dadi-vardhan/Assistive-Exoskelton/Fabricated_Design/Images/IMG-20190410-WA0003.jpg

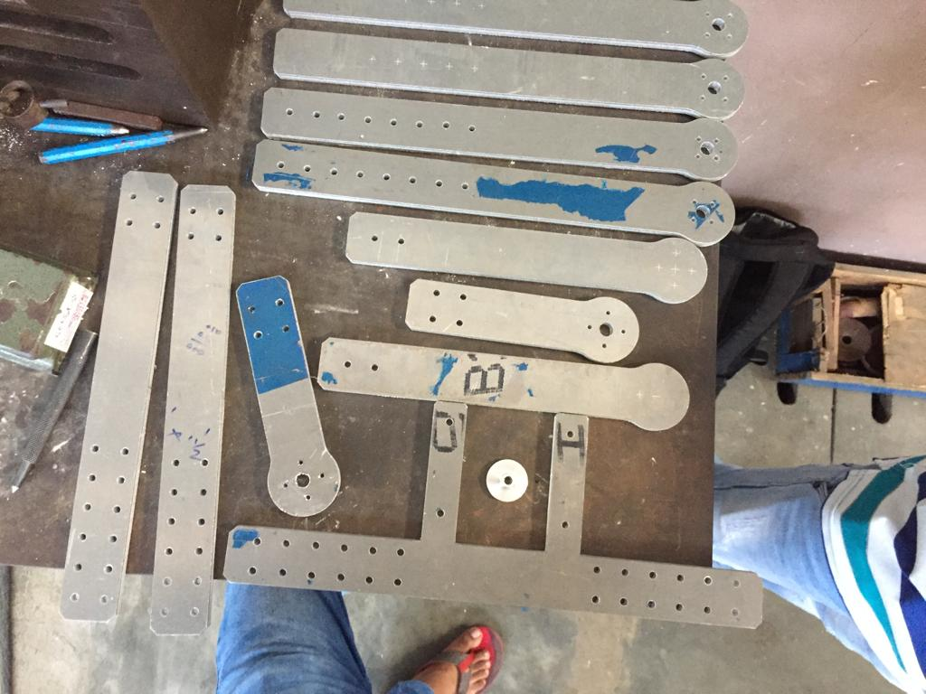
Fabricated_Design/Images/IMG-20190410-WA0003.jpg
