dadi-vardhan/Assistive-Exoskelton/Fabricated_Design/Images/Motor.PNG

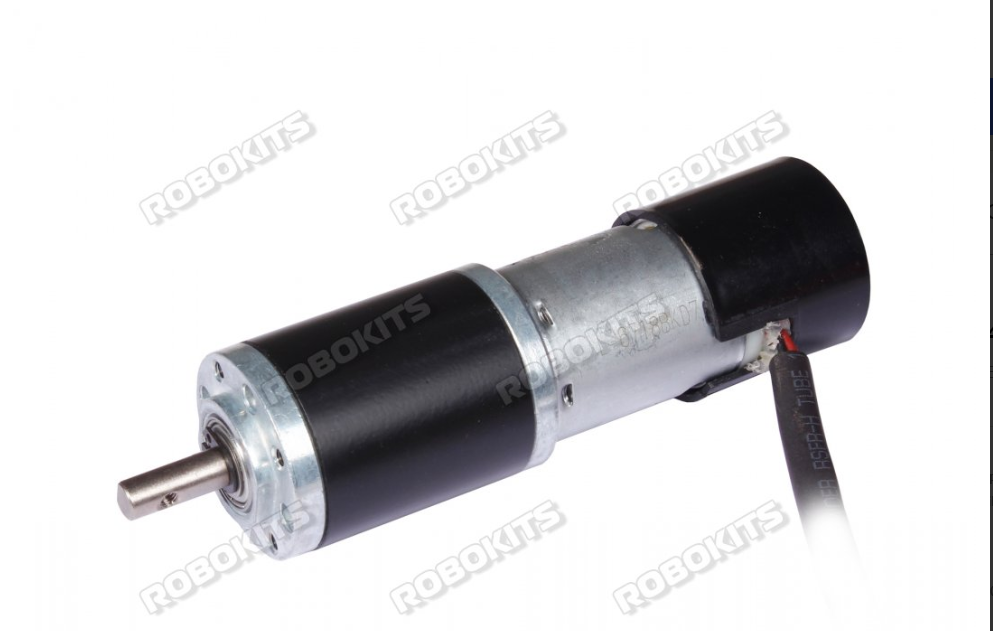
Fabricated_Design/Images/Motor.PNG
