dadi-vardhan/Assistive-Exoskelton/README.md

# Lower Limb Assistive Exoskeleton

Material = Aluminium 7075 T6;

DOF = SIX;

Type = Wearable Lower limb;

Drive_Type = Motor driven (DC brushless motors coupled with Harmonic Gear drive);

More details ------>>> [In the Report file]
