dadi-vardhan/Assistive-Exoskelton/Designed_Model/Images/Exoske1.JPG

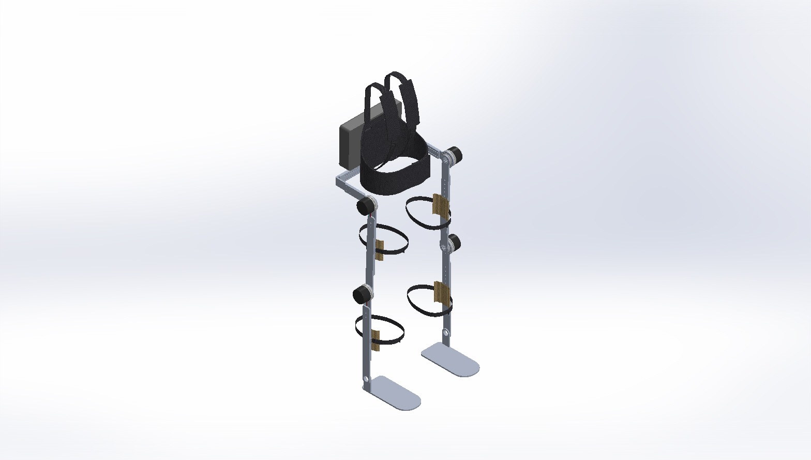
Designed_Model/Images/Exoske1.JPG
