dadi-vardhan/Assistive-Exoskelton/Designed_Model/Images/Exoskeleton.JPG

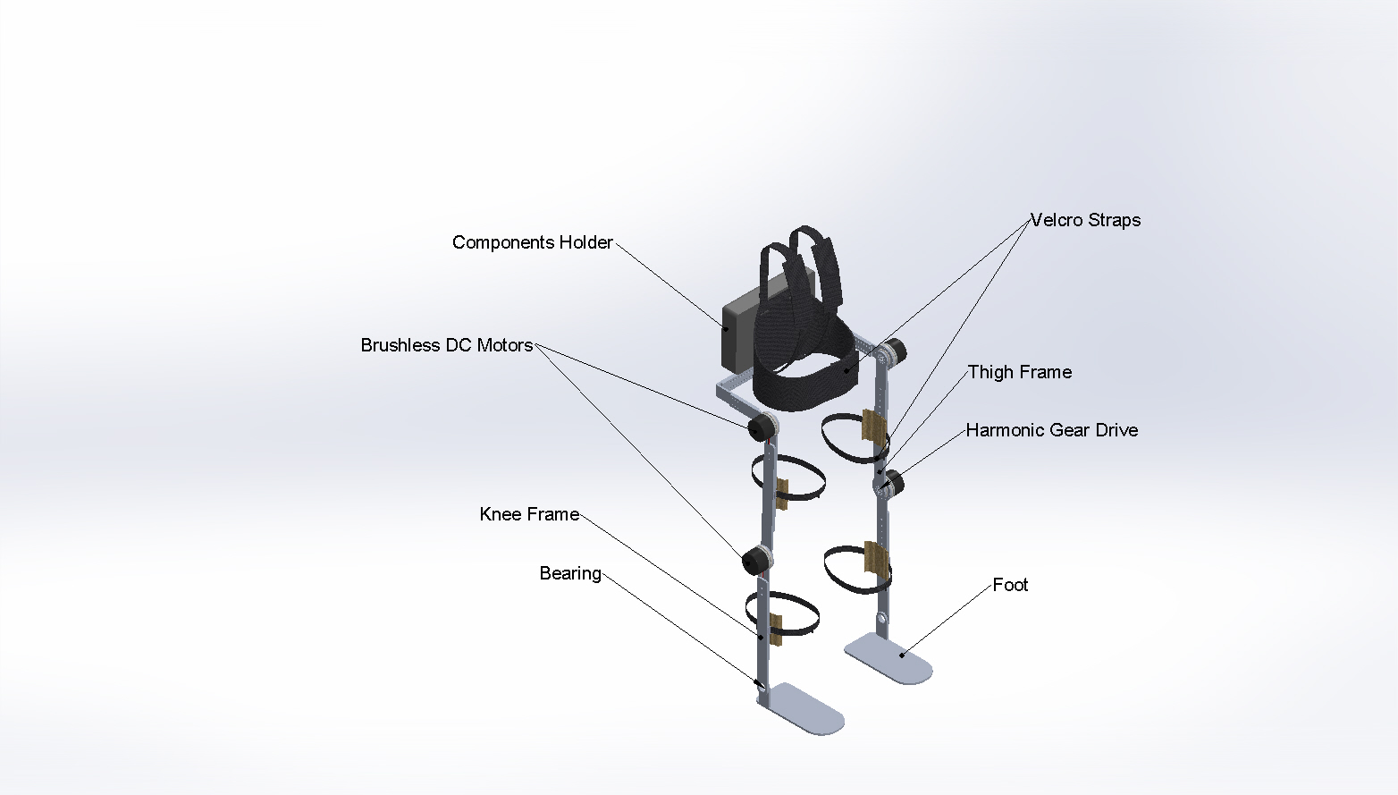
Designed_Model/Images/Exoskeleton.JPG
