dadi-vardhan/Assistive-Exoskelton/Designed_Model/Images/Height.JPG

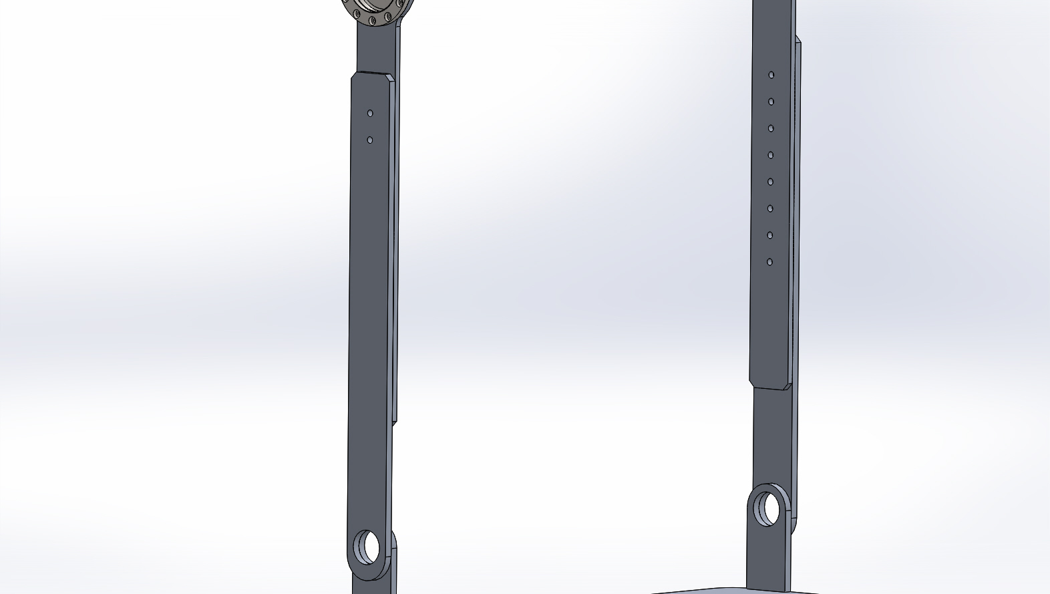
Designed_Model/Images/Height.JPG
