dadi-vardhan/Assistive-Exoskelton/Designed_Model/Images/HipAnalysis.JPG

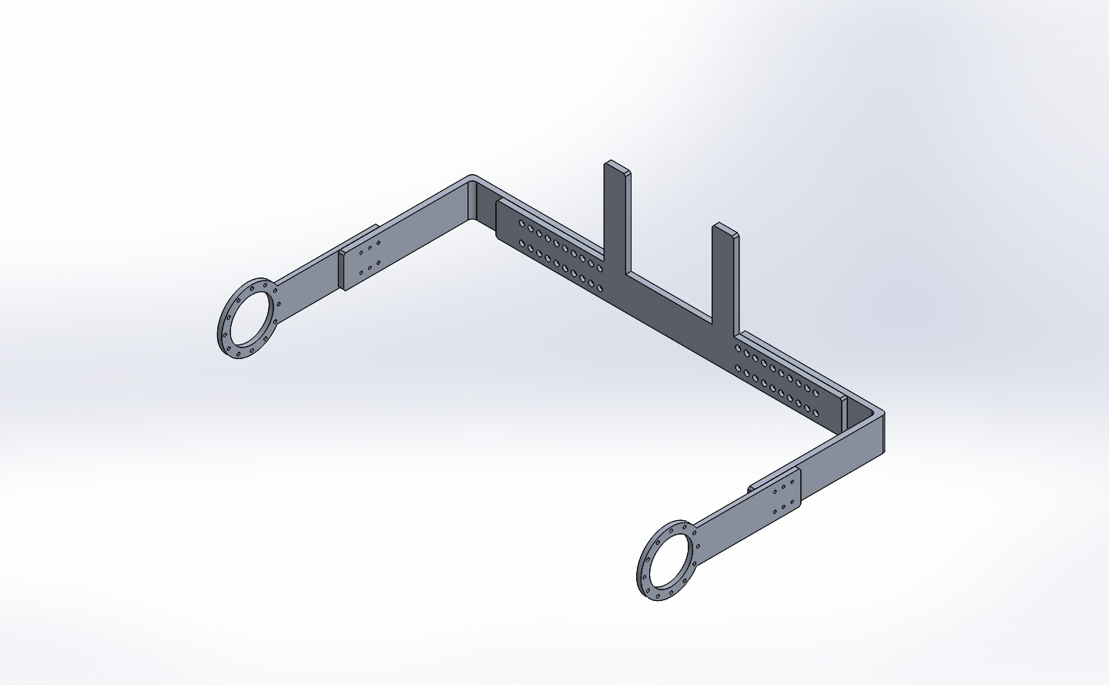
Designed_Model/Images/HipAnalysis.JPG
