dadi-vardhan/Assistive-Exoskelton/Fabricated_Design/Images/Specs.PNG

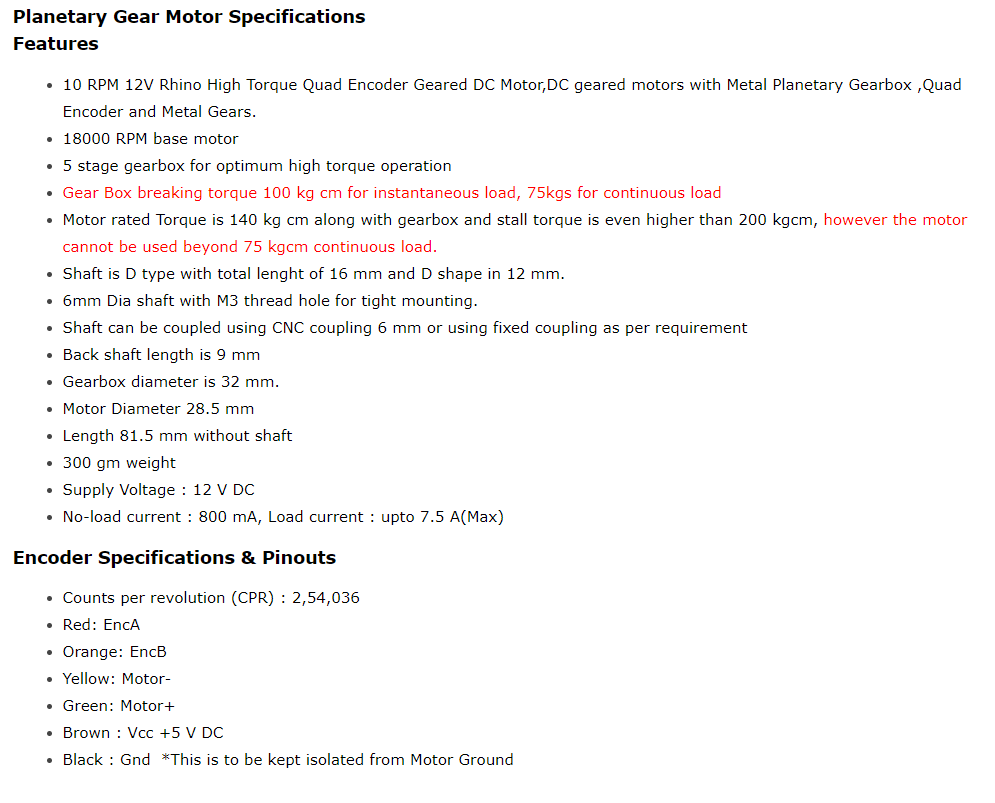
Fabricated_Design/Images/Specs.PNG
