dadi-vardhan/Assistive-Exoskelton/Designed_Model/HarmonicGear_Design/Parts/HarmonicGear.SLDASM

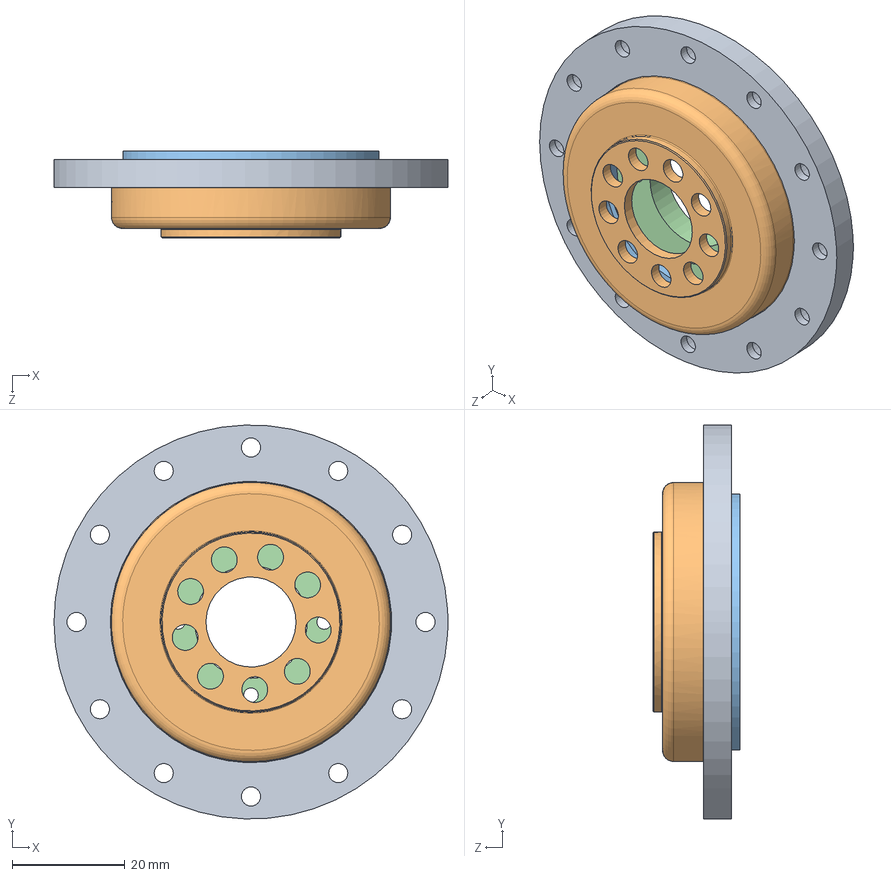
[picture p59: CAD file, 2019-06-01]
Designed_Model/HarmonicGear_Design/Parts/HarmonicGear.SLDASM
70.0 x 70.0 x 15.5 mm
CircularSpline
FlexSpline
Bearing
WaveGenerator
