dadi-vardhan/Assistive-Exoskelton/Designed_Model/PartFiles/Exoske.SLDASM

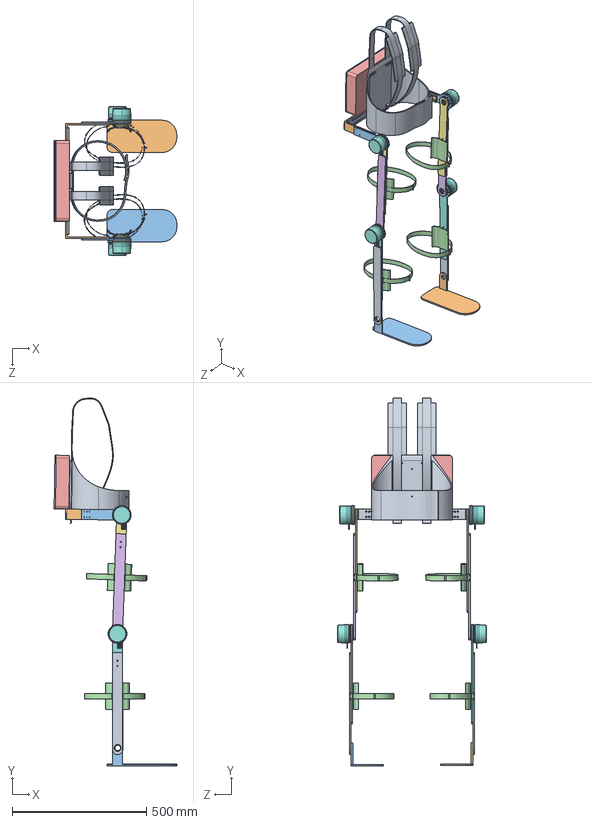
[picture p60: CAD file, 2019-06-01]
Designed_Model/PartFiles/Exoske.SLDASM
457.3 x 1370.5 x 553.9 mm
Hip_frame_1
Hip_frame_2 x 2
Hip_frame_3 x 2
CircularSpline x 4
FlexSpline x 4
Thigh_frame_hip_free x 2
Thigh_frame_free x 2
Knee_frame_fixed x 2
Knee_frame_free x 2
Left_foot
Right_foot
Velcro x 4
Components_Hold
Plate
WaveGenerator x 4
Motor x 4
Velcro-Chest
