dadi-vardhan/Assistive-Exoskelton/Fabricated_Design/Part-Files/Holder.SLDPRT

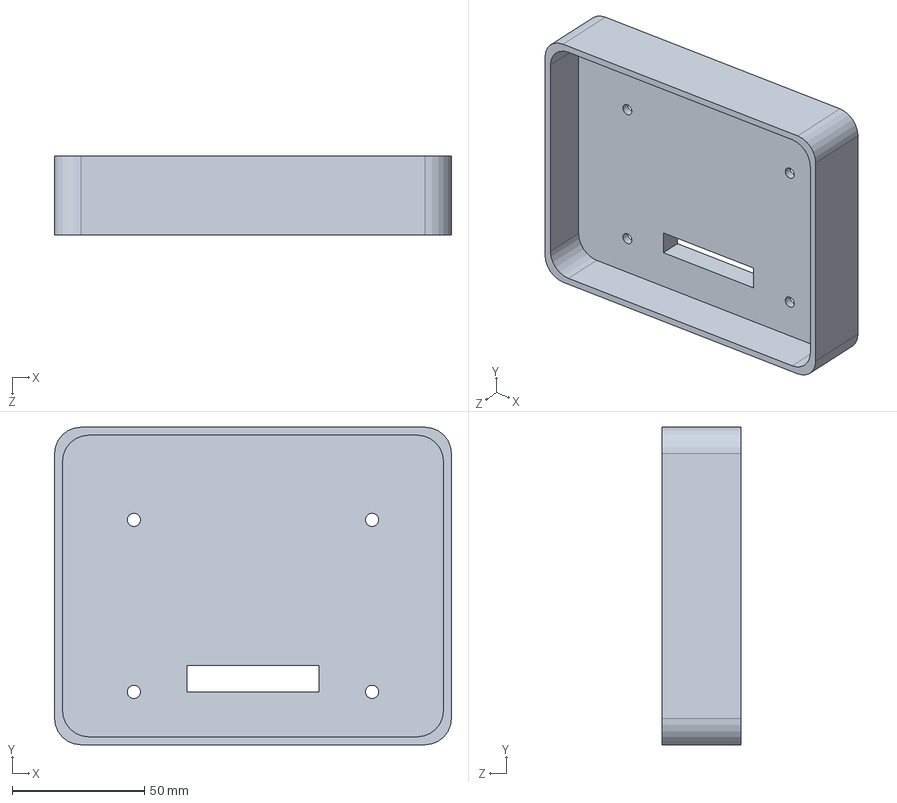
[picture p62: CAD file, 2019-06-01]
Fabricated_Design/Part-Files/Holder.SLDPRT
150.0 x 120.0 x 30.0 mm
