dadi-vardhan/Assistive-Exoskelton/Fabricated_Design/STEP-Files/Hip_Frame-1.STEP

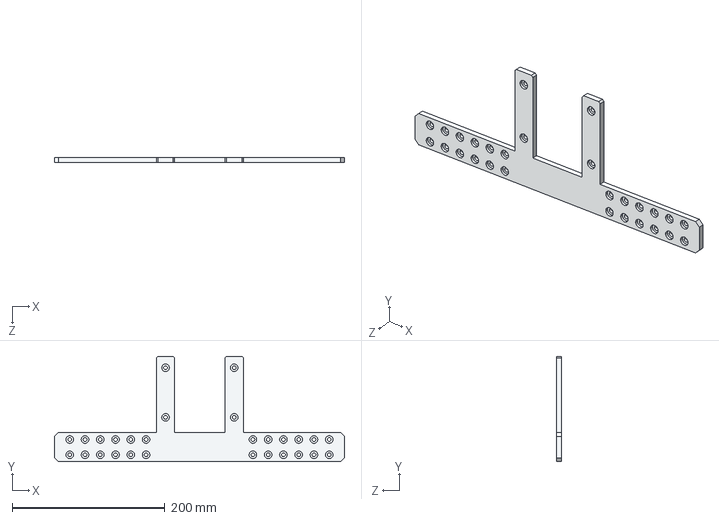
[picture p63: CAD file, 2019-06-01]
Fabricated_Design/STEP-Files/Hip_Frame-1.STEP
380.0 x 138.1 x 6.40 mm
