dadi-vardhan/Assistive-Exoskelton/Designed_Model/HarmonicGear_Design/StepFiles/FlexSpline.STEP

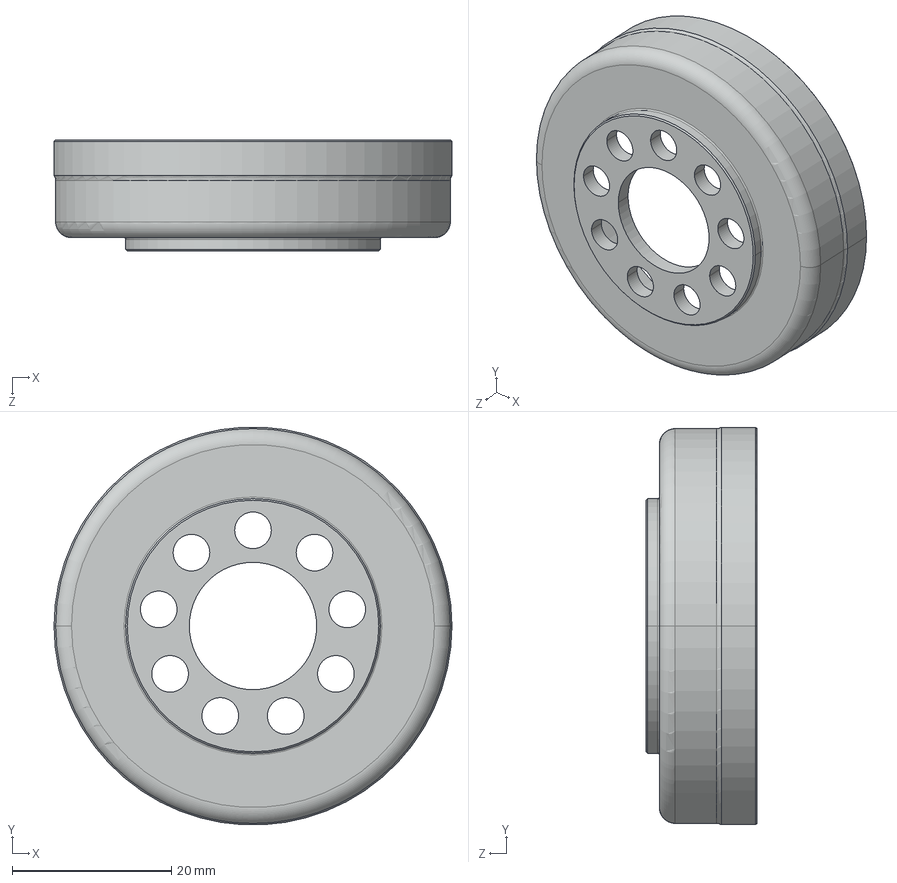
[picture p64: CAD file, 2019-06-01]
Designed_Model/HarmonicGear_Design/StepFiles/FlexSpline.STEP
50.0 x 49.9 x 14.0 mm
