dadi-vardhan/Assistive-Exoskelton/Designed_Model/StepFiles/Exo_Stand_Fixed.STEP

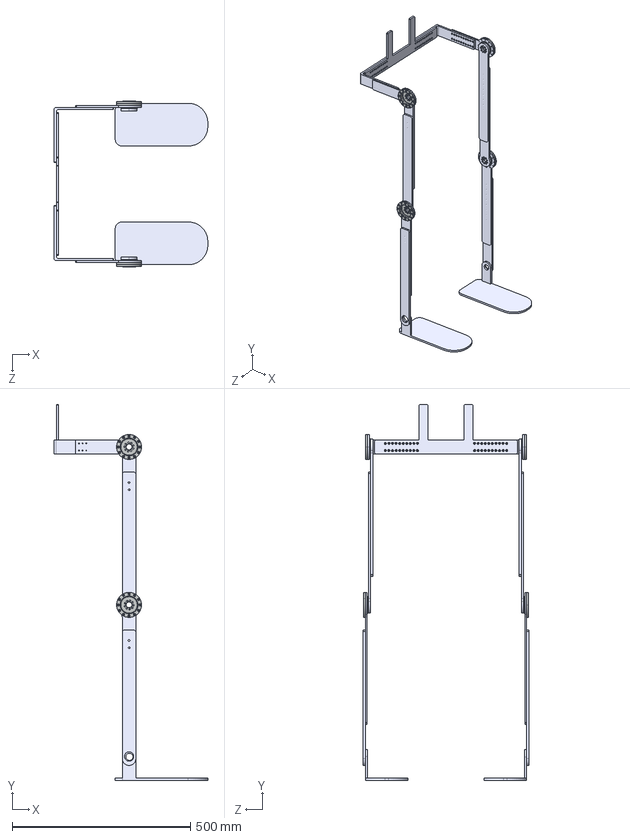
[picture p65: CAD file, 2019-06-01]
Designed_Model/StepFiles/Exo_Stand_Fixed.STEP
430.9 x 1054.1 x 465.4 mm
Hip_frame_1
Hip_frame_2 x 2
Hip_frame_3 x 2
CircularSpline x 4
FlexSpline x 4
Thigh_frame_hip_free x 2
Thigh_frame_free x 2
Knee_frame_fixed x 2
Knee_frame_free x 2
Left_foot
Right_foot
