dadi-vardhan/Assistive-Exoskelton/Fabricated_Design/STEP-Files/Thigh_Frame-1.STEP

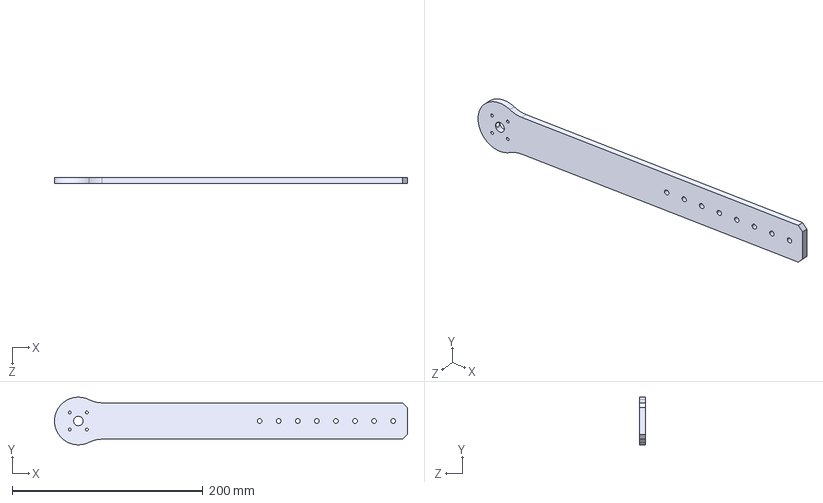
[picture p66: CAD file, 2019-06-01]
Fabricated_Design/STEP-Files/Thigh_Frame-1.STEP
370.0 x 50.0 x 6.40 mm
