dadi-vardhan/Assistive-Exoskelton/Designed_Model/HarmonicGear_Design/StepFiles/CircularSpline.STEP

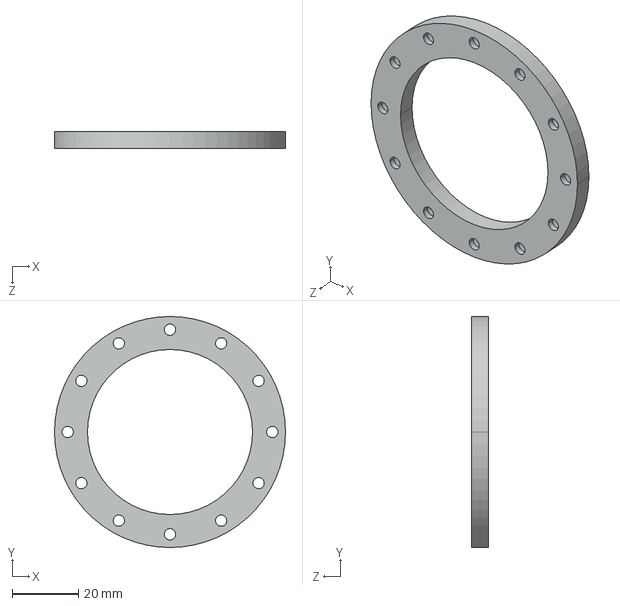
[picture p67: CAD file, 2019-06-01]
Designed_Model/HarmonicGear_Design/StepFiles/CircularSpline.STEP
70.0 x 70.0 x 5.00 mm
