dadi-vardhan/Assistive-Exoskelton/Fabricated_Design/STEP-Files/Hip_Frame-2.STEP

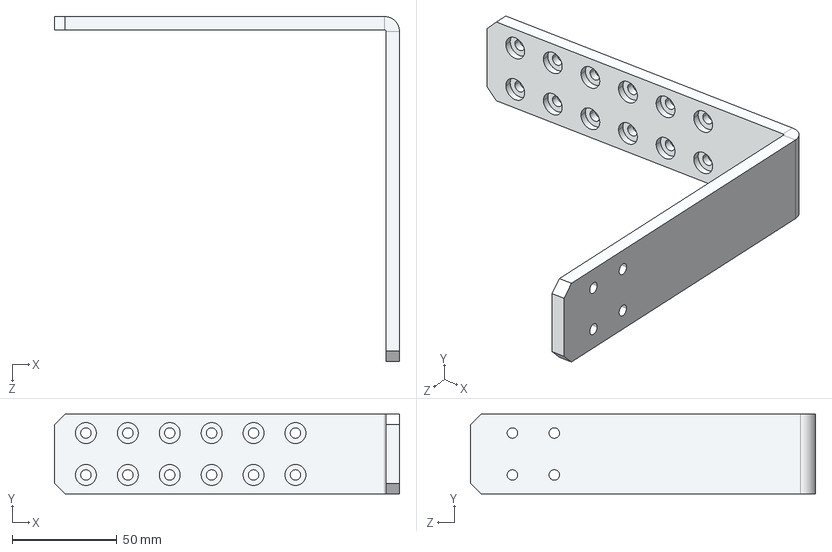
[picture p68: CAD file, 2019-06-01]
Fabricated_Design/STEP-Files/Hip_Frame-2.STEP
164.7 x 38.1 x 164.7 mm
