dadi-vardhan/Assistive-Exoskelton/Designed_Model/HarmonicGear_Design/StepFiles/WaveGenerator.STEP

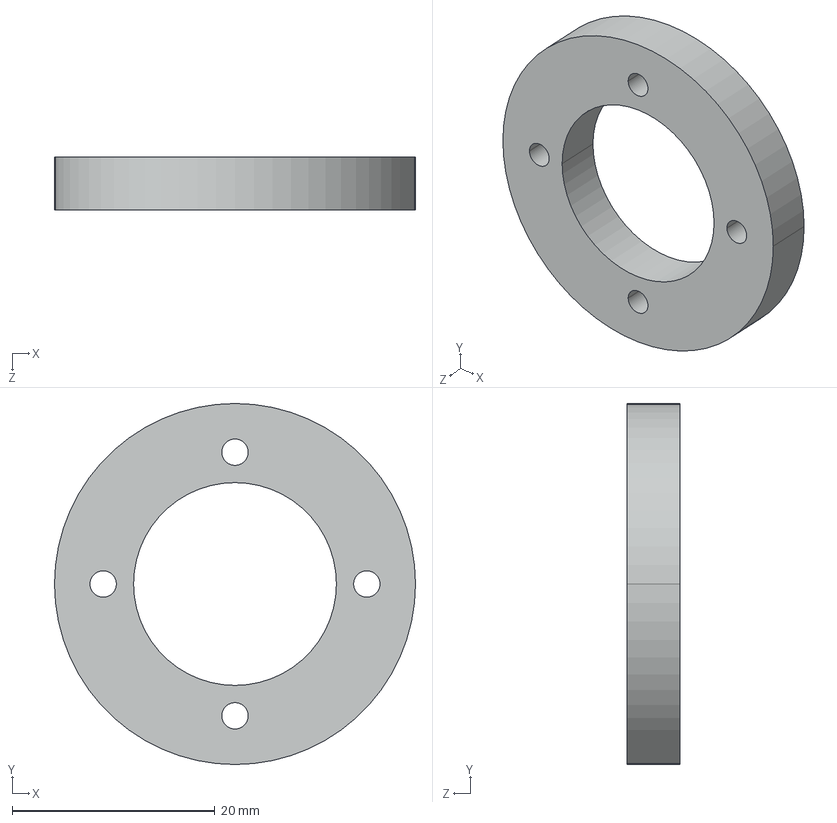
[picture p69: CAD file, 2019-06-01]
Designed_Model/HarmonicGear_Design/StepFiles/WaveGenerator.STEP
35.6 x 35.6 x 5.20 mm
