dadi-vardhan/Assistive-Exoskelton/Fabricated_Design/STEP-Files/Knee_Frame-2.STEP

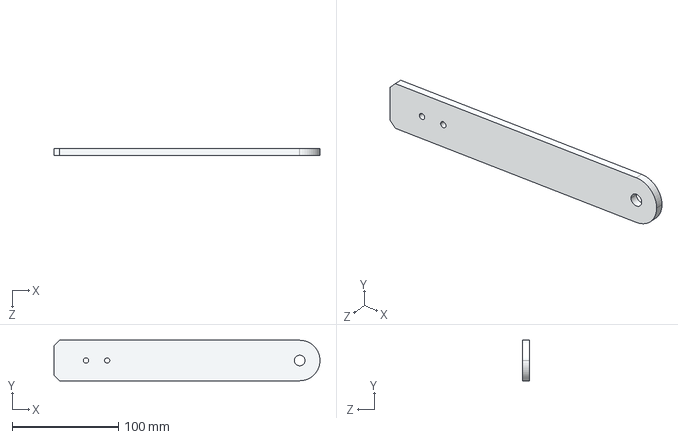
[picture p70: CAD file, 2019-06-01]
Fabricated_Design/STEP-Files/Knee_Frame-2.STEP
250.0 x 38.1 x 6.40 mm
