dadi-vardhan/Assistive-Exoskelton/Designed_Model/HarmonicGear_Design/StepFiles/Bearing.STEP

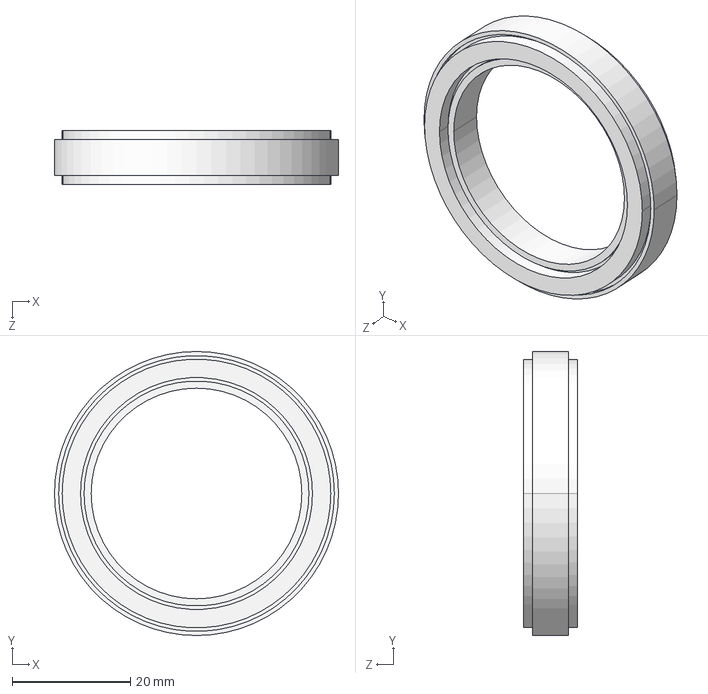
[picture p71: CAD file, 2019-06-01]
Designed_Model/HarmonicGear_Design/StepFiles/Bearing.STEP
48.0 x 48.0 x 9.10 mm
