dadi-vardhan/Assistive-Exoskelton/Fabricated_Design/STEP-Files/Flange.STEP

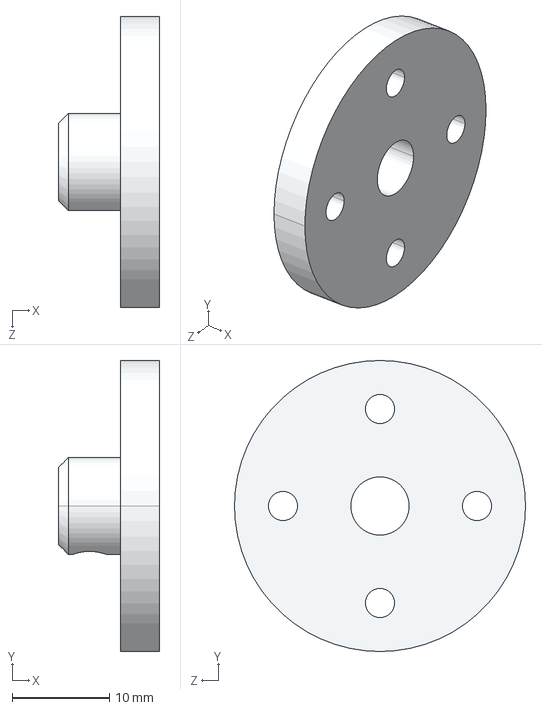
[picture p72: CAD file, 2019-06-01]
Fabricated_Design/STEP-Files/Flange.STEP
10.4 x 30.0 x 30.0 mm
