dadi-vardhan/Assistive-Exoskelton/Fabricated_Design/STEP-Files/Hip_Frame-3.STEP

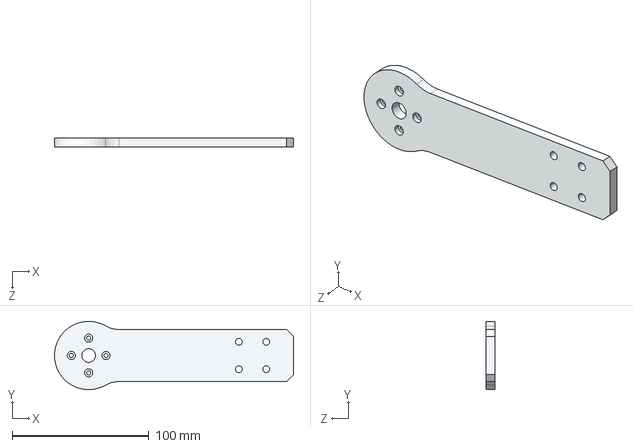
[picture p73: CAD file, 2019-06-01]
Fabricated_Design/STEP-Files/Hip_Frame-3.STEP
175.0 x 50.0 x 6.40 mm
