dadi-vardhan/Assistive-Exoskelton/Fabricated_Design/STEP-Files/Thigh_Frame-2.STEP

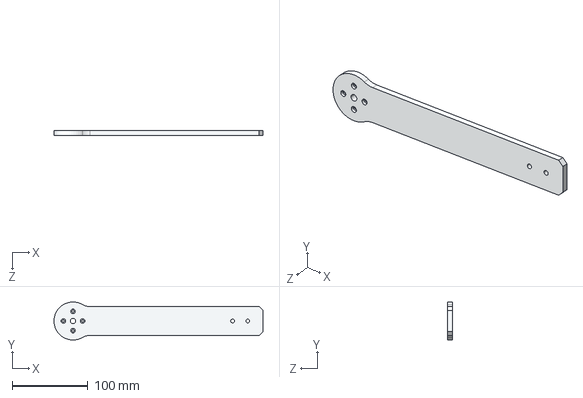
[picture p74: CAD file, 2019-06-01]
Fabricated_Design/STEP-Files/Thigh_Frame-2.STEP
275.0 x 50.0 x 6.40 mm
