dadi-vardhan/Assistive-Exoskelton/(list of files, cad)

Other CAD files:
Designed_Model/HarmonicGear_Design/StepFiles/HarmonicGearAssembly.STEP
Fabricated_Design/STEP-Files/Knee_Frame-1.STEP
Designed_Model/HarmonicGear_Design/Parts/Bearing.SLDPRT
Designed_Model/HarmonicGear_Design/Parts/CircularSpline.SLDPRT
Designed_Model/HarmonicGear_Design/Parts/FlexSpline.SLDPRT
Designed_Model/HarmonicGear_Design/Parts/WaveGenerator.SLDPRT
Designed_Model/PartFiles/Exo_Sit_Fixed.SLDASM
Designed_Model/PartFiles/Exo_Stand_Fixed.SLDASM
Fabricated_Design/DXF/Hip_Frame-1.DXF
Fabricated_Design/DXF/Hip_Frame-2.DXF
Fabricated_Design/DXF/Hip_Frame-3.DXF
Fabricated_Design/DXF/Knee_Frame-1.DXF
Fabricated_Design/DXF/Knee_Frame-2.DXF
Fabricated_Design/DXF/Thigh_Frame-1.DXF
Fabricated_Design/DXF/Thigh_Frame-2.DXF
Fabricated_Design/Part-Files/Flange.SLDPRT
Fabricated_Design/Part-Files/Hip_Frame-1.SLDPRT
Fabricated_Design/Part-Files/Hip_Frame-2.SLDPRT
Fabricated_Design/Part-Files/Hip_Frame-3.SLDPRT
Fabricated_Design/Part-Files/Knee_Frame-1.SLDPRT
Fabricated_Design/Part-Files/Knee_Frame-2.SLDPRT
Fabricated_Design/Part-Files/Thigh_Frame-1.SLDPRT
Fabricated_Design/Part-Files/Thigh_Frame-2.SLDPRT
