dadi-vardhan/Assistive-Exoskelton/Fabricated_Design/Images/fabrication.JPG

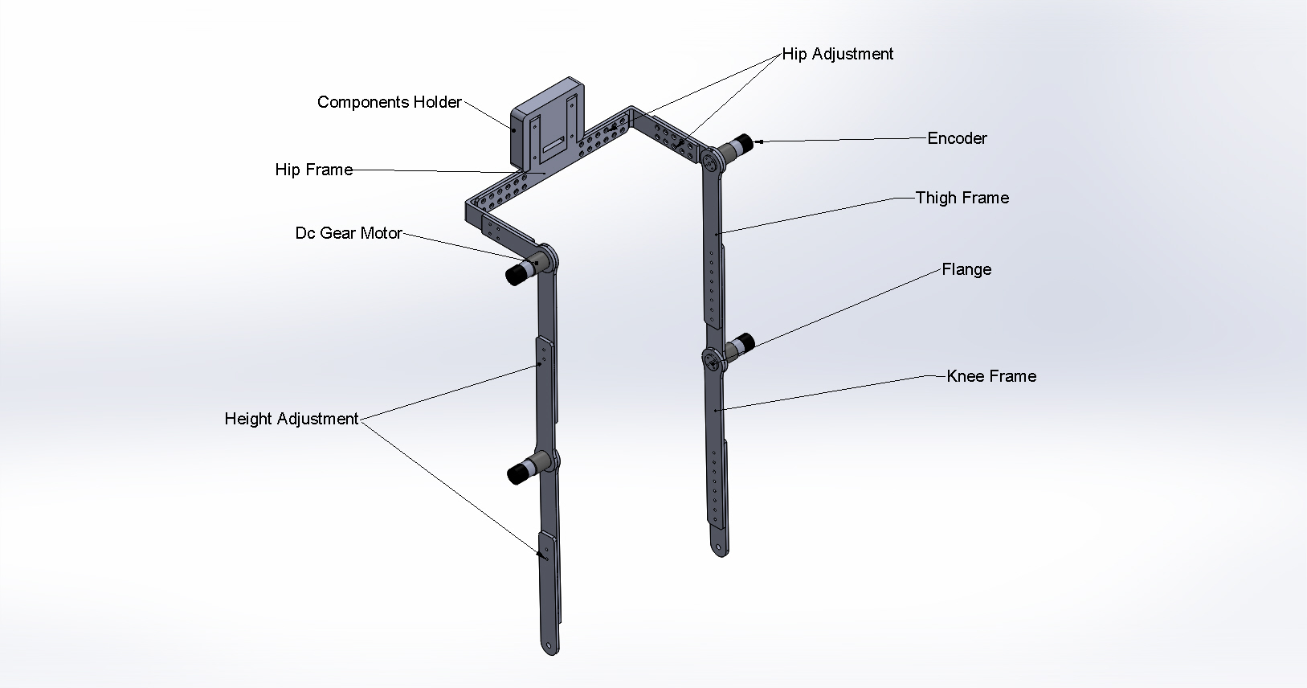
Fabricated_Design/Images/fabrication.JPG
