dadi-vardhan/Assistive-Exoskelton/Fabricated_Design/Images/Flange.JPG

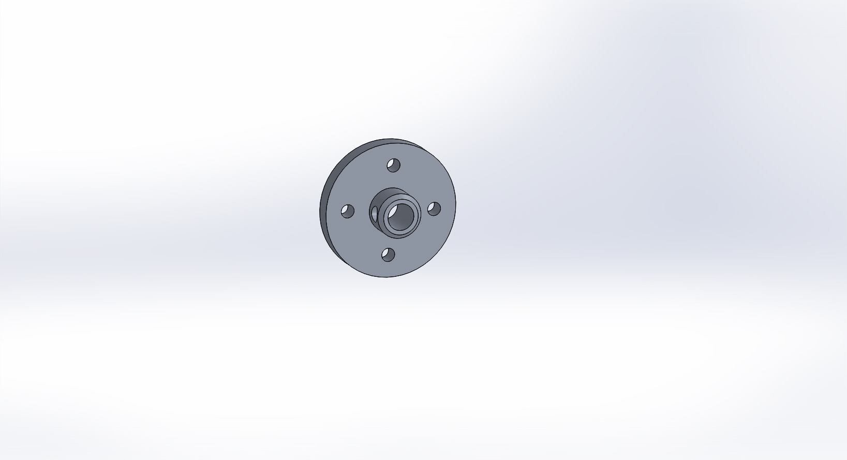
Fabricated_Design/Images/Flange.JPG
