dadi-vardhan/Assistive-Exoskelton/Fabricated_Design/Images/Height-Adjustment.JPG

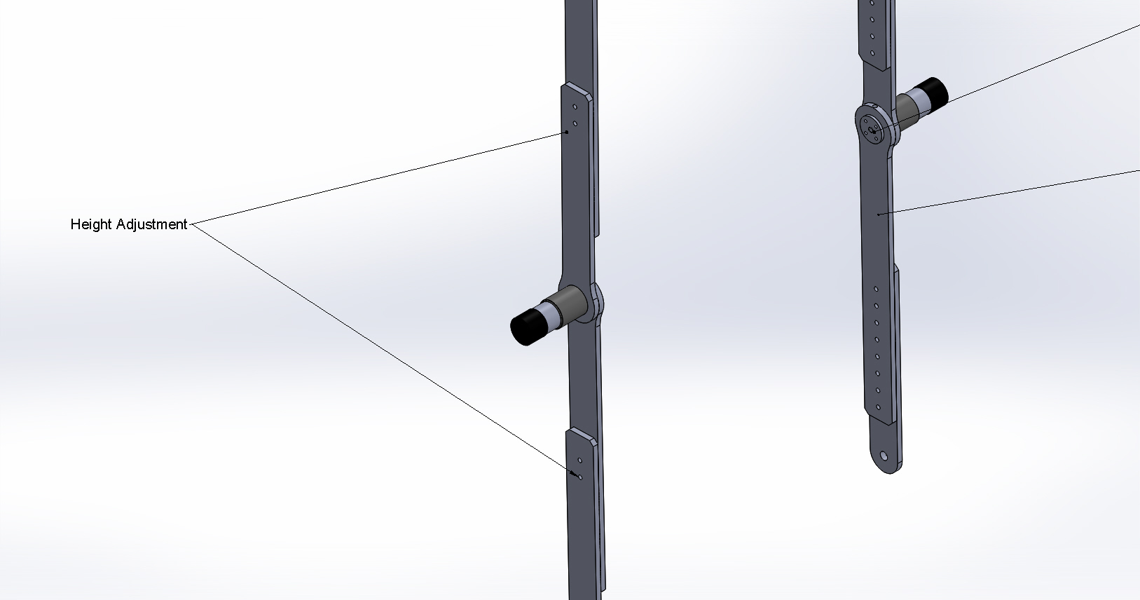
Fabricated_Design/Images/Height-Adjustment.JPG
