dadi-vardhan/Assistive-Exoskelton/Fabricated_Design/Images/IMG-20190410-WA0002.jpg

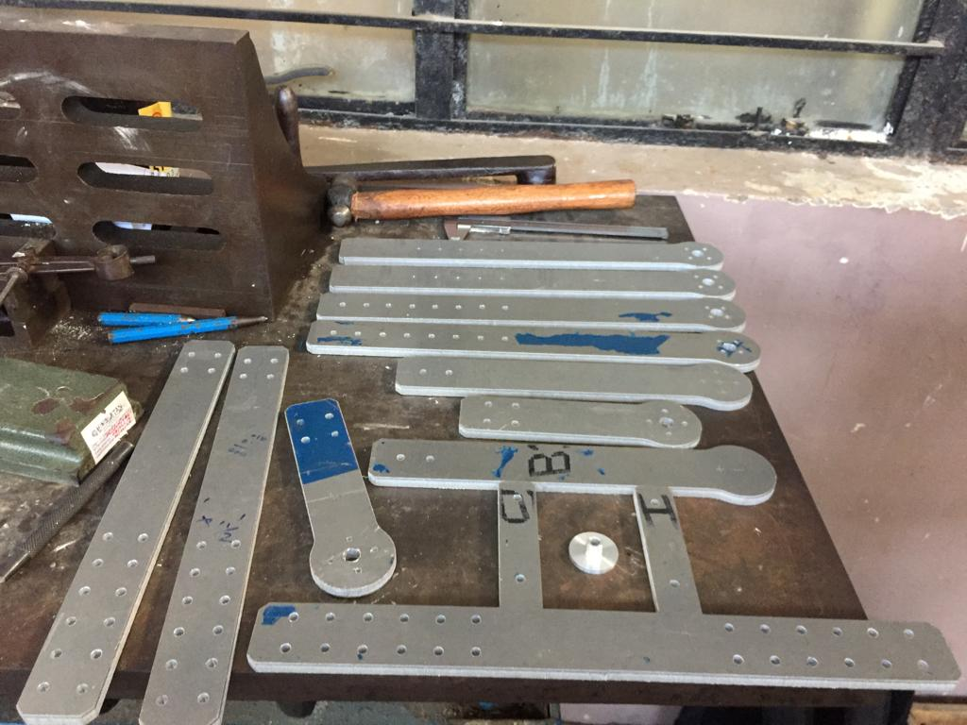
Fabricated_Design/Images/IMG-20190410-WA0002.jpg
