dadi-vardhan/Assistive-Exoskelton/Fabricated_Design/Images/IMG-20190413-WA0001.jpeg

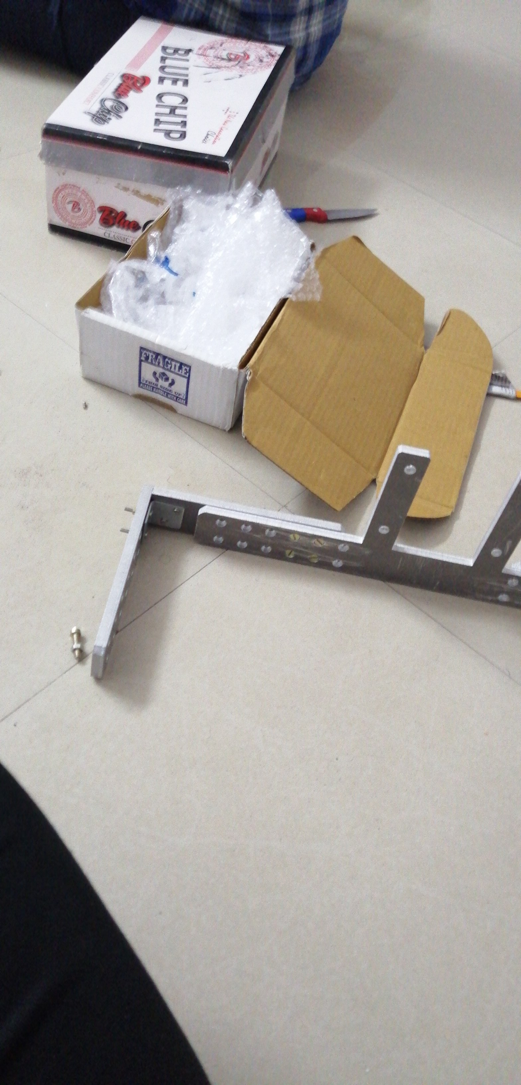
Fabricated_Design/Images/IMG-20190413-WA0001.jpeg
