dadi-vardhan/Assistive-Exoskelton/Fabricated_Design/Images/Thigh_Frame-1-.JPG

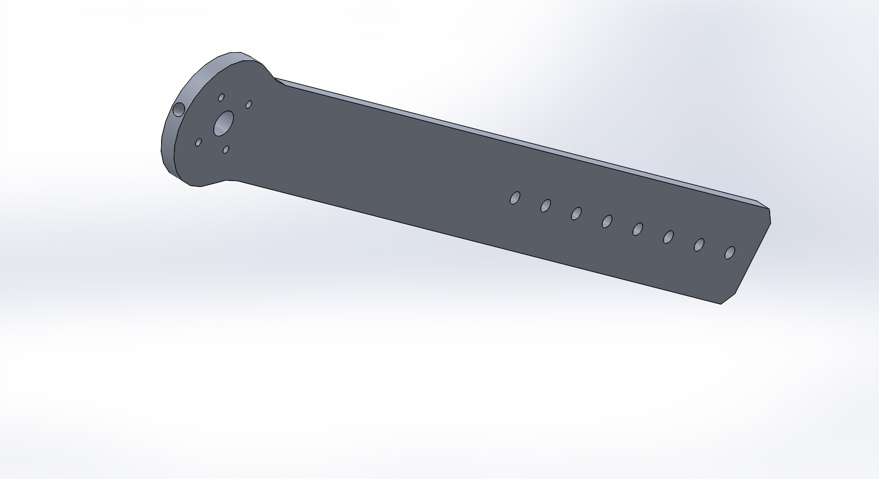
Fabricated_Design/Images/Thigh_Frame-1-.JPG
