dadi-vardhan/Assistive-Exoskelton/Fabricated_Design/Drafts-Pdf's/Flange_Main.PDF

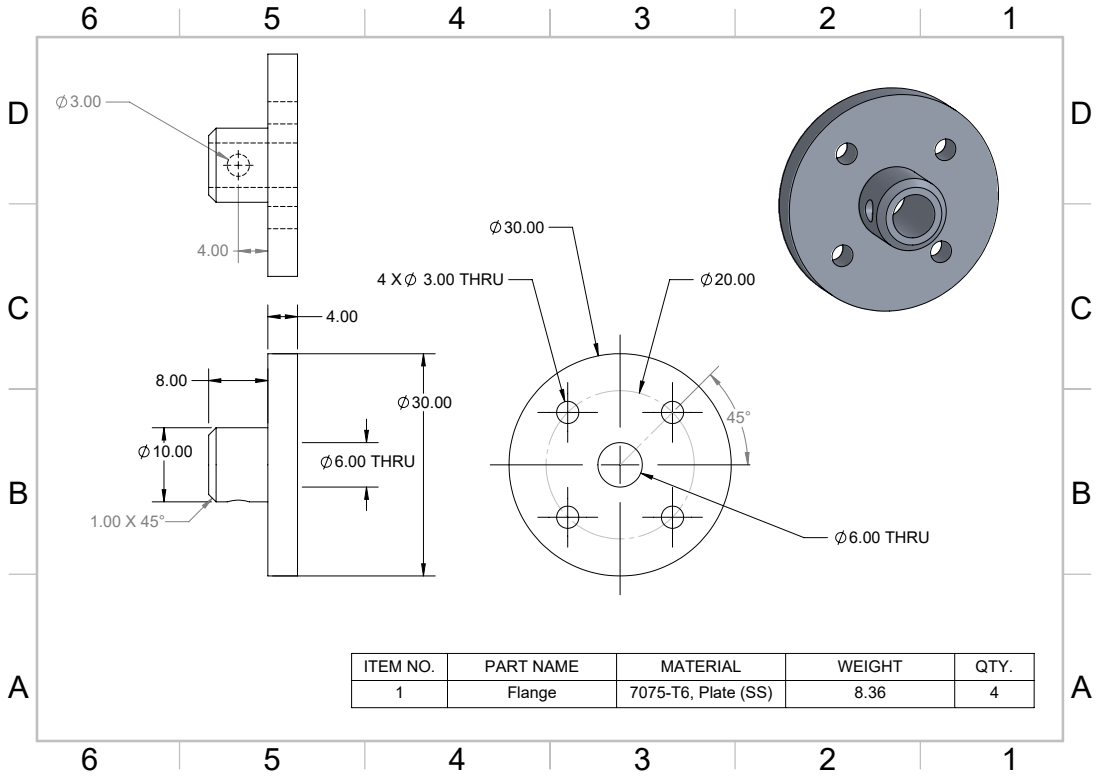
[picture p81: page 1]
6.00 THRU; 4 X 3.00 THRU; ITEM NO.; PART NAME; MATERIAL; WEIGHT; QTY.; Flange; 7075-T6, Plate (SS)
