dadi-vardhan/Assistive-Exoskelton/Fabricated_Design/Drafts-Pdf's/Hip_Frame-1.PDF

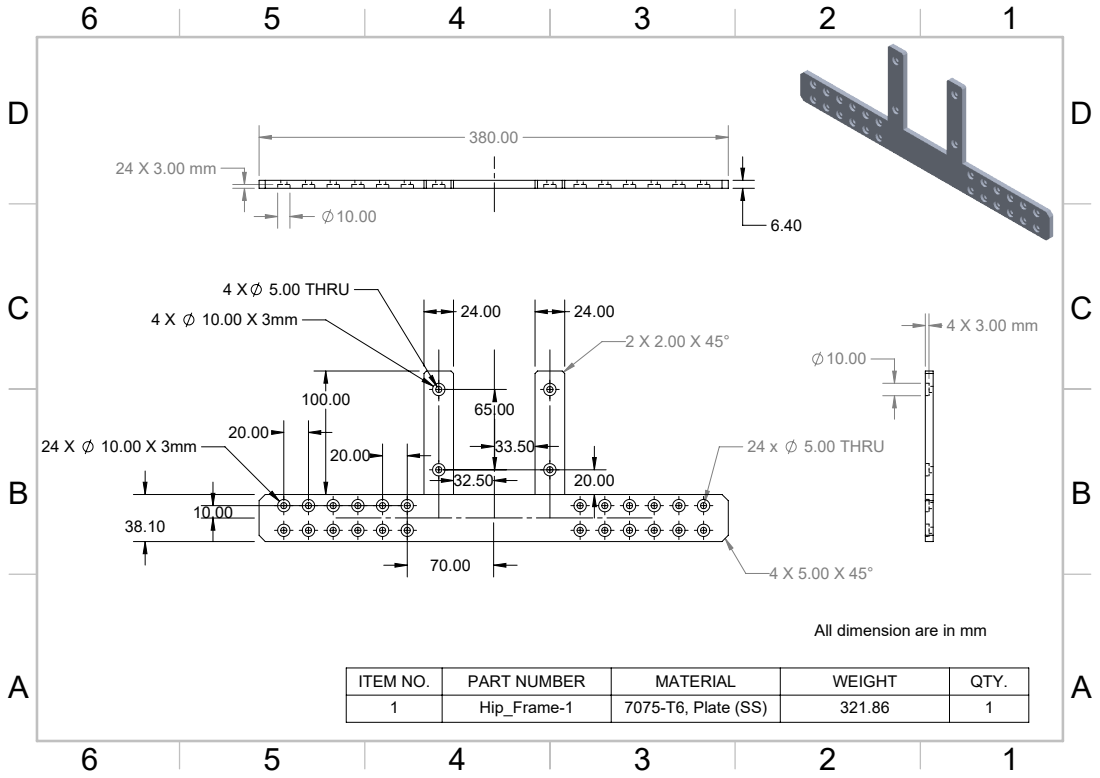
[picture p82: page 1]
4 X 5.00 THRU; 24 x 5.00 THRU

All dimension are in mm

ITEM NO. | PART NUMBER | MATERIAL | WEIGHT | QTY.
1 | Hip_Frame-1 | 7075-T6, Plate (SS) | 321.86 | 1
