dadi-vardhan/Assistive-Exoskelton/Fabricated_Design/Drafts-Pdf's/Hip_Frame-2.PDF

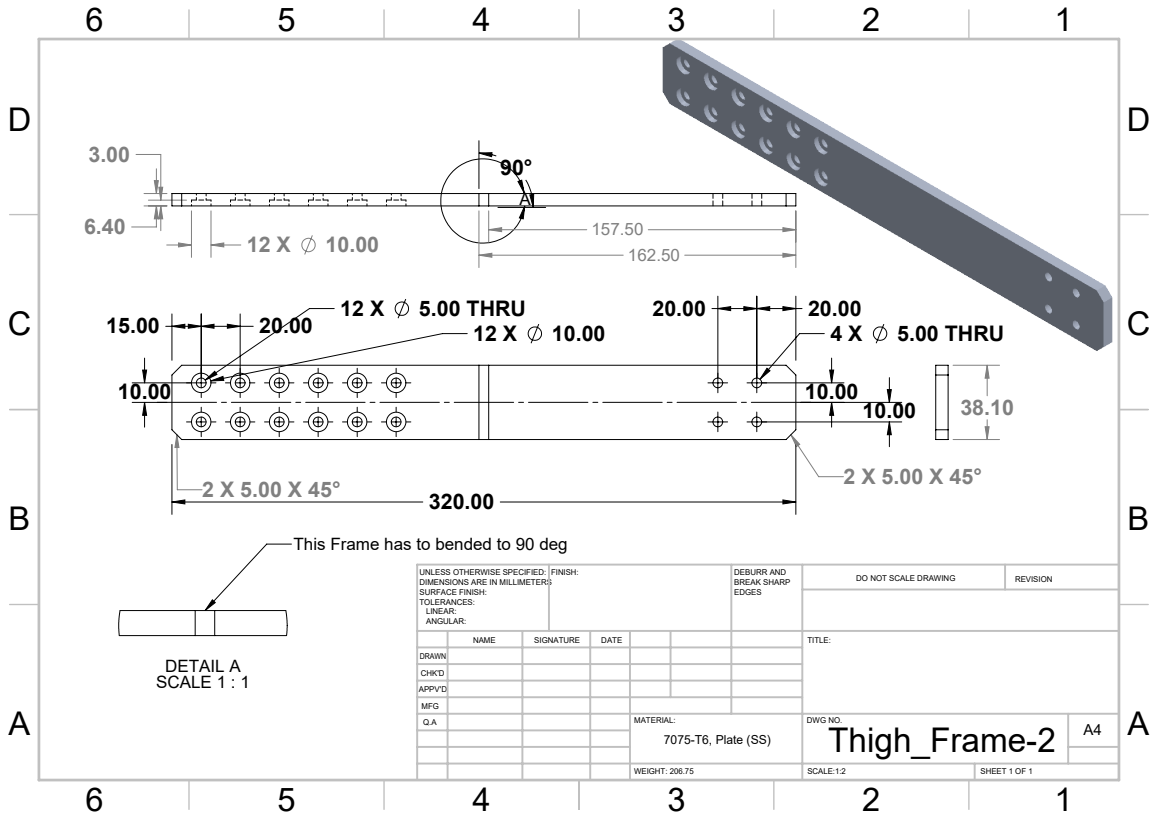
[picture p83: page 1]
12 X 5.00 THRU 20.00 4 X 5.00 THRU; DETAIL A SCALE 1 : 1; FINISH:; DEBURR AND; BREAK SHARP; DO NOT SCALE DRAWING; REVISION; SCALE:1:2; SHEET 1 OF 1; WEIGHT: 206.75

This Frame has to bended to 90 deg

UNLESS OTHERWISE SPECIFIED:
DIMENSIONS ARE IN MILLIMETERS
SURFACE FINISH:
TOLERANCES:
LINEAR:
ANGULAR:

NAME | SIGNATURE | DATE | | | | TITLE:

DRAWN
CHK'D
APPV'D
MFG
Q.A | | | | MATERIAL: 7075-T6, Plate (SS) | DWG NO. Thigh_Frame-2 | A4
