dadi-vardhan/Assistive-Exoskelton/Fabricated_Design/Drafts-Pdf's/Hip_Frame-3.PDF

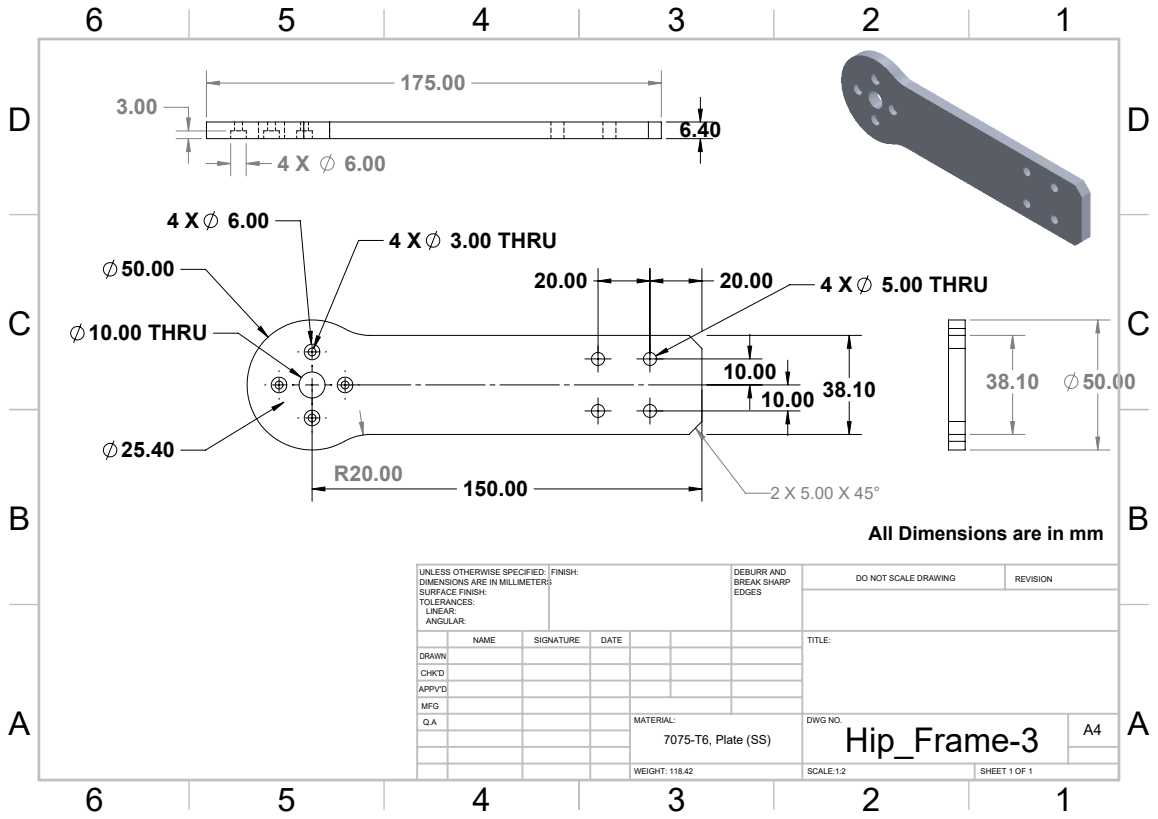
[picture p84: page 1]
10.00 THRU; 4 X 5.00 THRU 20.00; 4 X 3.00 THRU; FINISH:; DEBURR AND; BREAK SHARP; DO NOT SCALE DRAWING; REVISION; SCALE:1:2; SHEET 1 OF 1; WEIGHT: 118.42

All Dimensions are in mm

UNLESS OTHERWISE SPECIFIED:
DIMENSIONS ARE IN MILLIMETERS
SURFACE FINISH:
TOLERANCES:
LINEAR:
ANGULAR:

NAME | SIGNATURE | DATE | | | | TITLE:

DRAWN
CHK'D
APPV'D
MFG
Q.A | | | | MATERIAL: 7075-T6, Plate (SS) | DWG NO. Hip_Frame-3 | A4
