dadi-vardhan/Assistive-Exoskelton/Fabricated_Design/Drafts-Pdf's/Knee_Frame-1.PDF

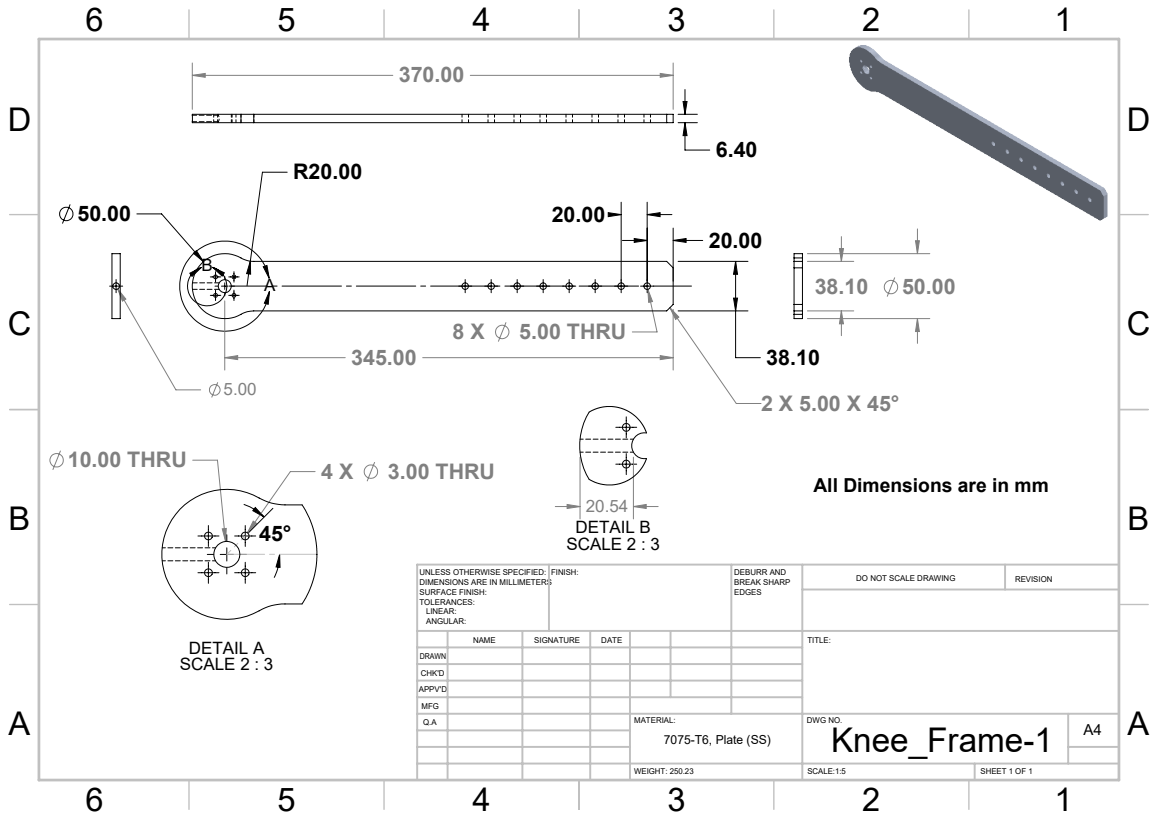
[picture p85: page 1]
8 X 5.00 THRU; 4 X 3.00 THRU 10.00 THRU; DETAIL A SCALE 2 : 3; DETAIL B SCALE 2 : 3; FINISH:; DEBURR AND; BREAK SHARP; DO NOT SCALE DRAWING; REVISION; SCALE:1:5; SHEET 1 OF 1; WEIGHT: 250.23

All Dimensions are in mm

UNLESS OTHERWISE SPECIFIED:
DIMENSIONS ARE IN MILLIMETERS
SURFACE FINISH:
TOLERANCES:
LINEAR:
ANGULAR:

NAME | SIGNATURE | DATE | | | | TITLE:

DRAWN
CHK'D
APPV'D
MFG
Q.A | | | | MATERIAL: 7075-T6, Plate (SS) | DWG NO. Knee_Frame-1 | A4
