dadi-vardhan/Assistive-Exoskelton/Fabricated_Design/Drafts-Pdf's/Knee_Frame-2.PDF

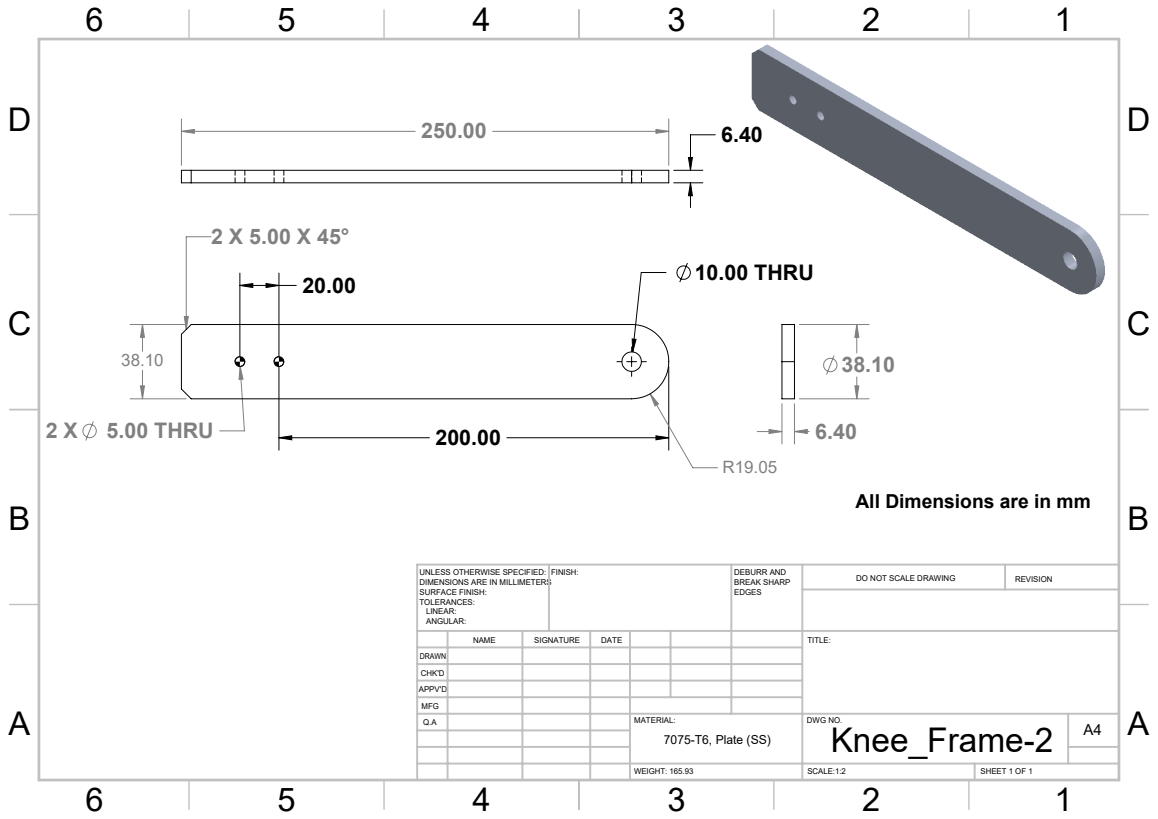
[picture p86: page 1]
20.00 10.00 THRU; 2 X 5.00 THRU; SCALE:1:2; SHEET 1 OF 1; DO NOT SCALE DRAWING; REVISION; DEBURR AND BREAK SHARP; UNLESS OTHERWISE SPECIFIED:; FINISH:

All Dimensions are in mm

DIMENSIONS ARE IN MILLIMETERS
SURFACE FINISH:
TOLERANCES:
LINEAR:
ANGULAR:

NAME | SIGNATURE | DATE | | | | TITLE:

DRAWN
CHK'D
APPV'D
MFG
Q.A | | | | MATERIAL: 7075-T6, Plate (SS) | DWG NO. Knee_Frame-2 WEIGHT: 165.93 | A4
