dadi-vardhan/Assistive-Exoskelton/Fabricated_Design/Drafts-Pdf's/Thigh_Frame-2.PDF

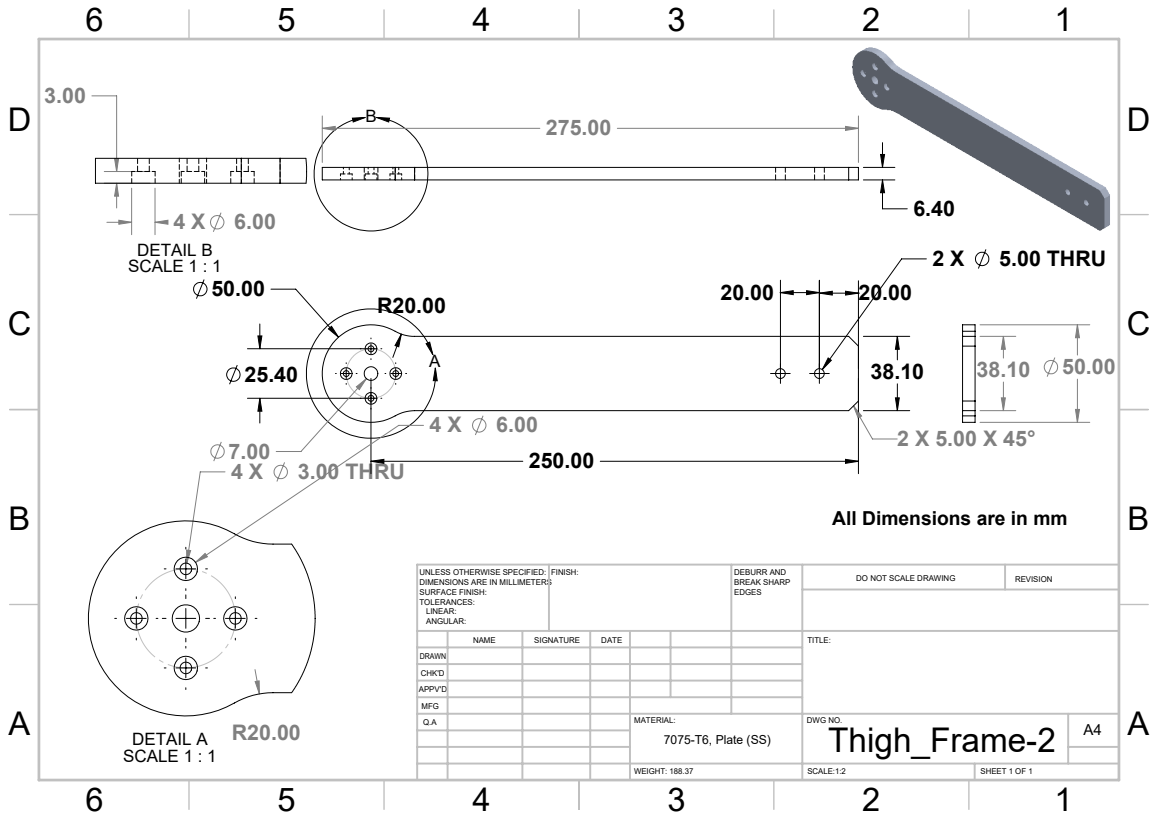
[picture p87: page 1]
2 X 5.00 THRU; 4 X 3.00 THRU; DETAIL A R20.00 SCALE 1 : 1; 4 X 6.00 DETAIL B SCALE 1 : 1; FINISH:; DEBURR AND; BREAK SHARP; DO NOT SCALE DRAWING; REVISION; SCALE:1:2; SHEET 1 OF 1; WEIGHT: 188.37

All Dimensions are in mm

UNLESS OTHERWISE SPECIFIED:
DIMENSIONS ARE IN MILLIMETERS
SURFACE FINISH:
TOLERANCES:
LINEAR:
ANGULAR:

NAME | SIGNATURE | DATE | | | | TITLE:

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
