dadi-vardhan/Assistive-Exoskelton/Fabricated_Design/Drafts-Pdf's/Thigh_Frame-1.PDF

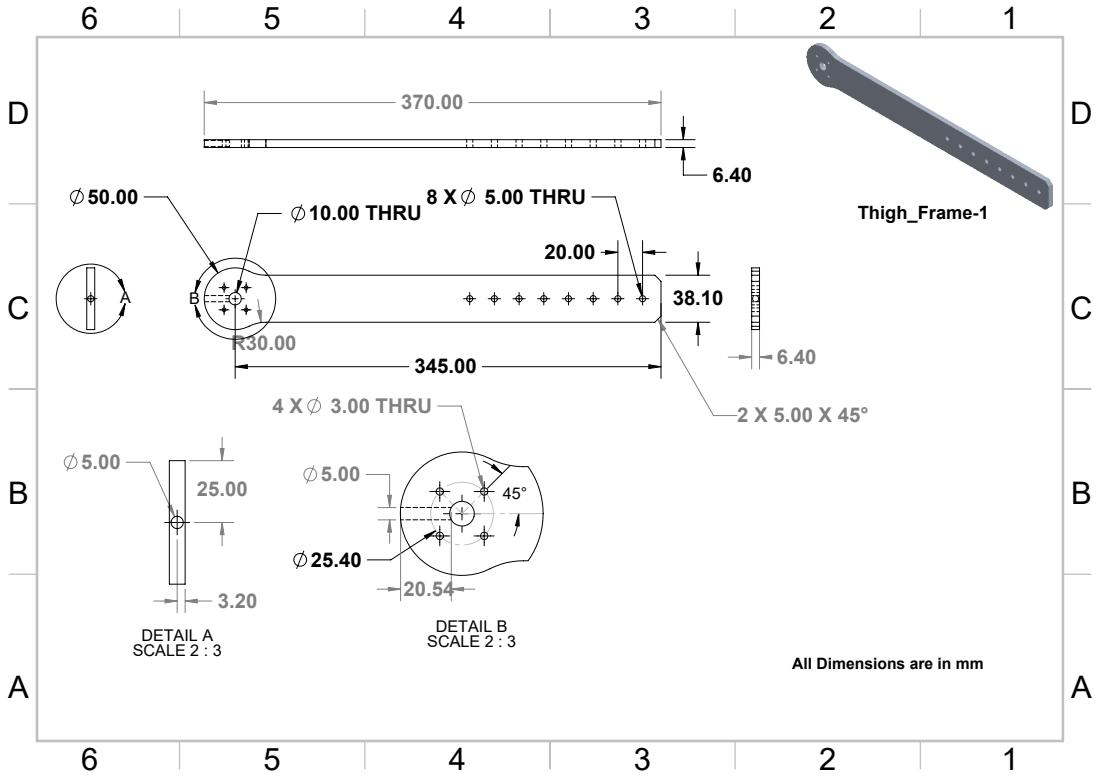
[picture p88: page 1]
10.00 THRU; 8 X 5.00 THRU; DETAIL A SCALE 2 : 3; 4 X 3.00 THRU; DETAIL B SCALE 2 : 3

All Dimensions are in mm
